Amr-Khaled-Amein/atmega32-metal-discriminator/(list of files, drawings)

Other design files:
hardware/proteus_simulation.sim1
